juliohgt/telescopio-dobson/(commit log)

2026-10-18 Controlador de telescopio Dobsoniano motorizado
    Firmware do Arduino Duemilanove (controlador de passos via HC-06 e DRV8825),
    software do PC em Python: calculo astronomico com skyfield, alinhamento por
    1 ou mais estrelas (rotacao de Kabsch), GoTo, rastreamento por velocidade,
    tela de controle com radar do ceu, simulador do Arduino e testes.
    Especificacoes em specs/. Ainda nao testado no hardware real.
2026-10-18 Firmware atende pelo USB e pelo HC-06; guia de instalacao
    O firmware so conversava pelo HC-06 (pinos 10/11), entao o cabo USB ficava
    mudo, ao contrario do que a documentacao dizia. Agora le os dois canais e
    responde pelo canal de origem de cada comando.
    Guia passo a passo em specs/instalacao.md (Python, Arduino IDE com
    ATmega328P ou ATmega168, pareamento do HC-06, problemas comuns). Comandos
    sem o activate, que a politica padrao do PowerShell bloqueia. Documentado
    que 4 testes pulam ate a efemeride ser baixada.
    [controlador.ino]
